EngenhariaTelecom/projeto-integrador-03/documentacao/imagens/telaInicio.png

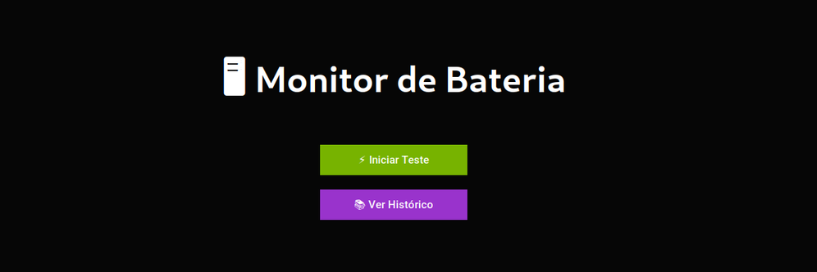
documentacao/imagens/telaInicio.png
