EngenhariaTelecom/projeto-integrador-03/ensaios_de_teste/ensaios/teste_100_ciclo_carga_descarga.csv

Tempo (s) | Tensao (V) | Corrente (A) | Modo | Carga | Descarga | Ciclo
0.1 |  |  | AUTO | OFF | OFF | 0
1.0 | 3.571 | 0.000 | AUTO | ON | OFF | 0
2.1 | 4.097 | 0.000 | AUTO | ON | OFF | 0
3.1 | 4.108 | 0.000 | AUTO | ON | OFF | 0
4.1 | 4.116 | 0.000 | AUTO | ON | OFF | 0
5.1 | 4.124 | 0.000 | AUTO | ON | OFF | 0
6.0 | 4.130 | 0.000 | AUTO | ON | OFF | 0
7.1 | 4.130 | 0.000 | AUTO | ON | OFF | 0
8.1 | 4.137 | 0.000 | AUTO | ON | OFF | 0
9.1 | 4.144 | 0.000 | AUTO | ON | OFF | 0
10.1 | 4.148 | 0.000 | AUTO | ON | OFF | 0
11.1 | 4.152 | 0.000 | AUTO | ON | OFF | 0
12.1 | 4.156 | 0.000 | AUTO | ON | OFF | 0
13.0 | 4.161 | 0.000 | AUTO | ON | OFF | 0
14.1 | 4.166 | 0.000 | AUTO | ON | OFF | 0
15.2 | 4.166 | 0.000 | AUTO | ON | OFF | 0
16.2 | 4.170 | 0.000 | AUTO | ON | OFF | 0
17.2 | 4.174 | 0.000 | AUTO | ON | OFF | 0
18.2 | 4.175 | 0.000 | AUTO | ON | OFF | 0
19.2 | 4.177 | 0.000 | AUTO | ON | OFF | 0
20.2 | 4.179 | 0.000 | AUTO | ON | OFF | 0
21.1 | 4.178 | 0.000 | AUTO | ON | OFF | 0
22.3 | 4.179 | 0.000 | AUTO | ON | OFF | 0
23.3 | 4.179 | 0.000 | AUTO | ON | OFF | 0
24.3 | 4.179 | 0.000 | AUTO | ON | OFF | 0
25.3 | 4.179 | 0.000 | AUTO | ON | OFF | 0
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
