EngenhariaTelecom/projeto-integrador-03/ensaios_de_teste/ensaios/teste_10_ciclo_carga_descarga.csv

Tempo (s) | Tensao (V) | Corrente (A) | Modo | Carga | Descarga | Ciclo
0.0 |  |  | AUTO | OFF | OFF | 0
1.1 |  |  | AUTO | OFF | OFF | 0
2.1 | 3.776 | 0.000 | AUTO | ON | OFF | 0
3.1 | 4.196 | 0.000 | AUTO | ON | OFF | 0
4.1 | 4.197 | 0.000 | AUTO | ON | OFF | 0
5.1 | 4.198 | 0.000 | AUTO | ON | OFF | 0
6.1 | 4.198 | 0.000 | AUTO | ON | OFF | 0
7.1 | 4.198 | 0.000 | AUTO | ON | OFF | 0
8.1 | 4.200 | 0.000 | AUTO | ON | OFF | 0
9.1 | 4.200 | 0.000 | AUTO | ON | OFF | 0
10.1 | 4.200 | 0.000 | AUTO | OFF | ON | 1
11.2 | 3.720 | 0.000 | MANUAL | OFF | OFF | 1
12.2 | 3.807 | 0.000 | MANUAL | OFF | OFF | 1
13.2 | 3.805 | 0.000 | MANUAL | OFF | OFF | 1
14.2 | 3.804 | 0.000 | MANUAL | OFF | OFF | 1
15.2 | 3.803 | 0.000 | MANUAL | OFF | OFF | 1
16.2 | 3.803 | 0.000 | MANUAL | OFF | OFF | 1
17.2 | 3.803 | 0.000 | MANUAL | OFF | OFF | 1
18.2 | 3.802 | 0.000 | MANUAL | OFF | OFF | 1
19.2 | 3.801 | 0.000 | MANUAL | OFF | OFF | 1
20.2 | 3.801 | 0.000 | MANUAL | OFF | OFF | 1
21.2 | 3.800 | 0.000 | MANUAL | OFF | OFF | 1
22.3 | 3.799 | 0.000 | MANUAL | OFF | OFF | 1
23.3 | 3.799 | 0.000 | MANUAL | OFF | OFF | 1
24.3 | 3.799 | 0.000 | MANUAL | OFF | OFF | 1
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
