EngenhariaTelecom/projeto-integrador-03/ensaios_de_teste/ensaios/teste_1_ciclo_carga.csv

Tempo (s) | Tensao (V) | Corrente (A) | Modo | Carga | Descarga
2.0 | 3.523 | 0.000 | AUTO | ON | OFF
2.0 | 4.004 | 0.000 | AUTO | ON | OFF
2.2 | 4.004 | 0.000 | AUTO | ON | OFF
3.0 | 4.017 | 0.000 | AUTO | ON | OFF
3.3 | 4.017 | 0.000 | AUTO | ON | OFF
4.2 | 4.028 | 0.000 | AUTO | ON | OFF
4.4 | 4.028 | 0.000 | AUTO | ON | OFF
5.4 | 4.036 | 0.000 | AUTO | ON | OFF
5.4 | 4.036 | 0.000 | AUTO | ON | OFF
6.5 | 4.036 | 0.000 | AUTO | ON | OFF
6.5 | 4.043 | 0.000 | AUTO | ON | OFF
7.6 | 4.043 | 0.000 | AUTO | ON | OFF
7.7 | 4.050 | 0.000 | AUTO | ON | OFF
8.6 | 4.050 | 0.000 | AUTO | ON | OFF
8.8 | 4.059 | 0.000 | AUTO | ON | OFF
9.7 | 4.059 | 0.000 | AUTO | ON | OFF
10.0 | 4.066 | 0.000 | AUTO | ON | OFF
10.8 | 4.066 | 0.000 | AUTO | ON | OFF
11.2 | 4.071 | 0.000 | AUTO | ON | OFF
11.8 | 4.071 | 0.000 | AUTO | ON | OFF
12.3 | 4.077 | 0.000 | AUTO | ON | OFF
12.9 | 4.077 | 0.000 | AUTO | ON | OFF
13.5 | 4.083 | 0.000 | AUTO | ON | OFF
14.0 | 4.083 | 0.000 | AUTO | ON | OFF
14.6 | 4.088 | 0.000 | AUTO | ON | OFF
15.0 | 4.088 | 0.000 | AUTO | ON | OFF
15.8 | 4.091 | 0.000 | AUTO | ON | OFF
16.1 | 4.091 | 0.000 | AUTO | ON | OFF
17.0 | 4.096 | 0.000 | AUTO | ON | OFF
17.2 | 4.096 | 0.000 | AUTO | ON | OFF
18.1 | 4.101 | 0.000 | AUTO | ON | OFF
18.3 | 4.101 | 0.000 | AUTO | ON | OFF
19.3 | 4.105 | 0.000 | AUTO | ON | OFF
19.3 | 4.105 | 0.000 | AUTO | ON | OFF
20.4 | 4.105 | 0.000 | AUTO | ON | OFF
20.4 | 4.110 | 0.000 | AUTO | ON | OFF
21.5 | 4.110 | 0.000 | AUTO | ON | OFF
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
1263.0 | 4.201 | 0.000 | AUTO | OFF | ON
1264.1 | 4.201 | 0.000 | AUTO | OFF | ON
1265.1 | 4.201 | 0.000 | AUTO | OFF | ON
1266.2 | 4.201 | 0.000 | AUTO | OFF | ON
1267.3 | 4.201 | 0.000 | AUTO | OFF | ON
1268.4 | 4.201 | 0.000 | AUTO | OFF | ON
1269.5 | 4.201 | 0.000 | AUTO | OFF | ON
