EngenhariaTelecom/projeto-integrador-03/ensaios_de_teste/ensaios/teste_2_ciclo_carga_descarga.csv

Tempo (s) | Tensao (V) | Corrente (A) | Modo | Carga | Descarga | Ciclo
0.1 |  |  | AUTO | OFF | OFF | 0
1.1 |  |  | AUTO | OFF | OFF | 0
2.1 | 3.930 | 0.000 | AUTO | ON | OFF | 0
3.1 | 4.166 | 0.000 | AUTO | ON | OFF | 0
4.1 | 4.166 | 0.000 | AUTO | ON | OFF | 0
5.1 | 4.168 | 0.000 | AUTO | ON | OFF | 0
6.1 | 4.168 | 0.000 | AUTO | ON | OFF | 0
7.1 | 4.170 | 0.000 | AUTO | ON | OFF | 0
8.1 | 4.170 | 0.000 | AUTO | ON | OFF | 0
9.1 | 4.171 | 0.000 | AUTO | ON | OFF | 0
10.2 | 4.172 | 0.000 | AUTO | ON | OFF | 0
11.2 | 4.173 | 0.000 | AUTO | ON | OFF | 0
12.2 | 4.173 | 0.000 | AUTO | ON | OFF | 0
13.2 | 4.171 | 0.000 | AUTO | ON | OFF | 0
14.2 | 4.171 | 0.000 | AUTO | ON | OFF | 0
15.2 | 4.170 | 0.000 | AUTO | ON | OFF | 0
16.2 | 4.170 | 0.000 | AUTO | ON | OFF | 0
17.2 | 4.170 | 0.000 | AUTO | ON | OFF | 0
18.2 | 4.167 | 0.000 | AUTO | ON | OFF | 0
19.3 | 4.167 | 0.000 | AUTO | ON | OFF | 0
20.3 | 4.168 | 0.000 | AUTO | ON | OFF | 0
21.3 | 4.166 | 0.000 | AUTO | ON | OFF | 0
22.3 | 4.168 | 0.000 | AUTO | ON | OFF | 0
23.3 | 4.166 | 0.000 | AUTO | ON | OFF | 0
24.3 | 4.166 | 0.000 | AUTO | ON | OFF | 0
25.3 | 4.167 | 0.000 | AUTO | ON | OFF | 0
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
