EngenhariaTelecom/projeto-integrador-03/(threads)

Thread 1 (2025-08-17):

Criação do Pitch

beatriz-paz, 2025-08-17:

beatriz-paz, 2025-08-17:
## Ideia geral:

- criação de protótipo para teste de carga e descarga de baterias;
- ter uma aplicação desktop que receba localmente as informação do teste (como tensão) e plote um gráfico de Tensão vs Tempo.

_Objetivo: este projeto tem como foco o uso por parte do desenvolvimento de produtos que utilizam baterias. Onde a análise do gráfico gerado pode tanto validar o funcionamento da bateria, como compreender se tal tipo de bateria serve para a aplicação pensada._

### Hardware

- usar a esp32;
- sensores de tensão e corrente;
- banco de resistores (para controle da descarga).

### Software

- Apache - Netbeans (possivelmente);
- recebe via broker mqtt os dados e trata eles para plotagem dos resultados.

Closed 2025-08-21.

Thread 4 (2025-08-31):

Criação de questionário para coletar/alinhar informações para nortear o desenvolvimento

beatriz-paz, 2025-08-31:

julia-e2002, 2025-09-02:
### Pesquisa sobre especificações/características da bateria PSA 3,7V - 500mAh

Esse tipo de bateria é útil em aplicações pequenas, leves, de baixo consumo constante e com poucas variações de temperatura. Além disso, é sensível a sobrecarga/descarga profunda, exigindo circuito de proteção (muitas já possuem).

A [Placa de sinalização sempre acesa ](https://backend.intelbras.com/sites/default/files/2022-10/Datasheet%20PSA125.pdf) da Intelbras utiliza bateria de íon-lítio 3,7V, porém é 600 mAh.

Outras aplicações desse tipo de bateria são:

⦁	[Rastreador de animais de estimação ](https://lipolybatteries.com/3-7v-500mah-lp602240-pet-tracker-polymer-lithium-battery)
⦁	[Monitor de Frequência Cardíaca Fetal](https://lipolybatteries.com/3-7v-500mah-polymer-battery-lp552540-for-fetal-heart-rate-monitor)
⦁	Sensores e Sistemas Embarcados
⦁	Dispositivos portáteis de baixo consumo
⦁	Sistemas de segurança e IoT
⦁	Brinquedos eletrônicos recarregáveis

Alguns datasheets com essas especificações:

⦁	[Li-ion Polymer 500mAh Battery Datasheet](https://www.mouser.com/datasheet/2/855/ASR00035_500mAh-3078648.pdf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)

⦁	[3.7V Lithium Polymer Battery Data Sheet](https://www.fpbattery.com/wp-content/uploads/2024/06/fpbattery-293450-3.7V-500mAh-Lithium-Polymer-Battery-Specification.pdf) (com gráfico de carga e descarga)

⦁	[3.7 V 500mAh Lithium Ion Battery 602535](https://www.ufinebattery.com/images/upload/ufx0212-13-3-7v-500mah-lithium-ion-battery-product-datasheet.pdf) (com gráficos)

Thread 8 (2025-09-02):

M1 - Semana 1 - Pesquisa sobre métodos atuais de teste de baterias

beatriz-paz, 2025-09-02:

BudaKin, 2025-09-07:
Antes de falar de como os testes funcionam, é importante estabelecer alguns conceitos. Cada bateria possui uma especificação própria, então tudo o que for mostrado aqui não se aplica genericamente a qualquer bateria. Para verificar esses dados, é necessário a leitura das informações fornecidas pela fabricante ou por alguma testadora certificada.

Entre as baterias que pretendemos verificar estão:

- [**Bateria de lítio 3,7 V - 500mAh**](https://www.mouser.com/datasheet/2/855/ASR00035_500mAh-3078648.pdf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)
- [**Bateria de lítio 3,7 V - 600 mAh**](https://www.fpbattery.com/wp-content/uploads/2024/06/fpbattery-403450-3.7V-600mAh-Lithium-Polymer-Battery-Specification.pdf)
- [**Bateria de lítio 3,7 V - 1 Ah**](https://www.li-polymer-battery.com/wp-content/uploads/2021/08/LP453653-3.7V-1000mAh-Datasheet.pdf)
- [**Bateria Alcalina 9 V**](https://www.farnell.com/datasheets/1842389.pdf)
- **Bateria de lítio 14,8V - 1500 mAh**
- **Bateria de lítio 14,8 V - 1200 mAh**
- **Bateria de lítio 2 x 12 V - 1,2 Ah**
- **Bateria de lítio 2 x 12 V – 2,3 Ah**

# Especificações de baterias

Quando se fala de bateria, os principais atributos sempre são **capacidade (Ah)** e **tensão (V)**, e isso não é diferente quando falamos de testes. Justamente esses atributos serão responsáveis pelos dados de maior relevância para tabelas, já que podem demonstrar a degradação da bateria.

## Tensão

Juntando informações das baterias, em um datasheet por exemplo, encontra-se a **tensão nominal**, que é justamente a tensão indicada na bateria. Porém, isso não significa que a bateria tem exatamente esse valor.

Na verdade, uma bateria saudável e carregada **deve ter mais que a tensão nominal**.

Por exemplo, a primeira bateria citada anteriormente: *Bateria de lítio 3,7 V - 500mAh*.
Apesar de possuir **3,7 V de tensão nominal**, tende a ter sua tensão com:

- **0% carregada:** ~2,45 V
- **100% carregada:** ~4,20 V

Esses valores podem ser confirmados lendo as especificações fornecidas.

Portanto, antes de qualquer coisa, é importante verificar se sua bateria possui a tensão próxima dessa faixa. Caso ela apresente valores anormais, isso é um forte indício de comprometimento. Normalmente, isso acontece quando uma bateria permanece "parada" por muito tempo, já que existe uma corrente pequena e constante atuando sobre ela — a chamada **corrente de flutuação**.

## Capacidade

Por fim, mas não menos importante, temos a **capacidade da bateria**, medida em **Ampère-hora (Ah)**, que determina quanto de corrente elétrica essa bateria consegue "armazenar".

Exemplo:
Se uma bateria possui **500 mAh**, e ela estiver energizando um aparelho com uma corrente de **50 mA**, essa bateria conseguirá mantê-lo funcionando por **10 horas**.

Esse atributo é relativamente simples de compreender e, por conta disso, é muito testado, já que a sua medição é de fácil reprodução. É nesse momento que entra o **teste de carga e descarga da bateria**, que coloca esse atributo em prova.

Inegavelmente, nenhuma bateria durará para sempre. Por trás de todas as reações químicas realizadas para a carga e uso de uma bateria, sempre haverá sobras de compostos inúteis nesse processo. Assim, a cada ciclo, a bateria perde desempenho.

Os **ciclos de vida da bateria** também são verificados dessa forma, observando-se o impacto que cada reação possui em sua degradação.

Thread 10 (2025-09-08):

M2 - Semana 3 - Pesquisa sobre criação de circuito de carga

beatriz-paz, 2025-09-08:

beatriz-paz, 2025-09-16:
# Circuitos de carga

### Carregador de bateria de 12v:

- https://www.youtube.com/watch?v=SH95hUC7Pus

### Carregador de bateria de 3,7v:

- https://www.fvml.com.br/2020/03/circuito-carregador-de-bateria-li-ion.html
- https://mx.pinterest.com/pin/70650287899242183/
- https://www.facebook.com/61562060977999/posts/carregador-de-bateria-de-l%C3%ADtio-37vesse-%C3%A9-um-circuito-carregador-de-bateria-de-%C3%ADo/122150493692402032/
- https://www.youtube.com/watch?v=pzSDKZdhiQM
- https://www.youtube.com/watch?v=sMWMVoF-3EM
- **https://www.youtube.com/watch?v=OpxyC2taLm4**

Closed 2025-09-22.

Thread 14 (2025-09-23):

M2 - Semana 4 - caso de uso e criação das telas

Lucascf11, 2025-09-23:
O caso de uso inclui o que cada parte do software e o cliente final são capazes de fazer. Na lógica da projeção tem-se que O cliente final é cliente do frontend, que é cliente do backend e este é cliente do hardware. Abaixo podemos verificar os casos de uso e os requisitos:

**Caso de Uso do Frontend**

Abaixo segue o caso de uso do FrontEnd, cujos requisitos são:

- Para que o cliente possa fazer qualquer coisa, ele precisa selecionar a bateria
- Para que o cliente possa pausar ou parar ciclos, ele deve ter iniciado um
- Para que o cliente possa visualizar histórico ou exportar informações, ele precisa ter finalizado ao menos um ciclo

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

**Caso de Uso do Backend**

Em seguida segue o caso de uso do Backend, cujo cliente é o Frontend e os requisitos são:

- Só é possível arquivar informações de ciclo único, mostrar gráfico de carga ou descarga, se iniciar um ciclo único
- Assim como só é possível arquivar informaçoes de vários ciclos, se ao menos dois ciclos tiverem sido finalizados
- O Frontend só consegue mostrar informaçoes de teste atual se ao menos um ou mais ciclos ainda estiverem em andamento

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

**Caso de Uso do Hardware**

Por último, segue o caso de uso do Hardware, cujo cliente é o backend da aplicação e há mais alguns requisitos:

- O backend só consegue informar o tempo de carga ou descarga, após coleta das demais informações
- A informação da saúde da bateria somente pode ser obtida após análise do tempo de carga e descarga em comparação com as especificaçoes da bateria

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

Todos os casos de uso acima unificados dão uma ideia geral de como será a aplicação. As informações que o Backend coleta do hardware são importantes para permitirem as operações do Frontend, que fará a interface com o usuário final e permitir que ele opere o sistema e obtenha as informações que foram propostas no levantamento de requisitos.

No figma, um esboço inicial dos resultados de carga e descarga de acordo com a corrente mAh das baterias sempre sendo de 3,7V:
[Figma baterias](https://www.figma.com/make/cQ8kuYb7TMZIOEGwCy3EgQ/Aplicativo-de-Medi%C3%A7%C3%A3o-de-Bateria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)

Closed 2025-10-07.

Thread 16 (2025-10-07):

M3 - Semana 6 - Estudo sobre chave analógica digital para tornar o circuito genérico para qualquer bateria de até 12v

beatriz-paz, 2025-10-07:
# Chave analógica - circuito de seleção de bateria

- Datasheet: https://br.mouser.com/datasheet/3/101/1/MC14066B-D.PDF

- Vídeo:

     - https://www.youtube.com/watch?v=e-30tZggdhc
     - https://www.youtube.com/watch?v=Gm7hGxGIf58

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

beatriz-paz, 2025-10-07:
Vamos precisar utilizar outro tipo de chave, como um rele, pois esta que estávamos analisando por mais que seja um circuito compacto não atende quanto a corrente de operação.

Closed 2025-10-07.
