EngenhariaTelecom/projeto-integrador-03/bateria_app/core/monitor.py

# core/monitor.py
import serial
import serial.tools.list_ports
from .bateria import BateriaController
import threading
import time
import os
import csv

class ESPReader(threading.Thread):
    """
    Thread que lê dados da ESP32 via serial.
    Grava CSV por timer periódico controlado (para evitar gravações duplicadas).
    Possui controle de envio periódico de comandos (USB ON).
    """

    def __init__(self, porta=None, baudrate=115200):
        super().__init__(daemon=True)

        self.porta = porta
        self.baudrate = baudrate
        self.ser = None

        # IMPORTANTE: não começa rodando, mas run() garante ativação
        self.running = False
        self._stop_requested = False

        self.ultima_leitura = None
        self.ultima_tensao = None
        self.corrente = None
        self.modo = "AUTO"
        self.carga = "OFF"
        self.descarga = "OFF"

        self.arquivo_csv = None
        self.tempo_inicial = time.time()
        self.bateria_controller = BateriaController(self)

        # Envio periódico
        self._envio_ativo = False
        self._thread_envio = None
        self._envio_intervalo = 3
        self._envio_comando = "USB ON"

        # Gravação periódica
        self.enviando = False
        self._save_timer = None
        self._save_interval = 1.0

        # Proteções
        self._last_save_time = 0.0
        self._save_min_interval = 0.8
        self._ciclo_cache = 0

        # Watchdog
        self._ultimo_dado_ts = time.time()
        self._timeout_serial = 5.0

        # Controller (UI)
        self.controller = None


    # ===============================
    # CSV
    # ===============================
    def definir_csv(self, caminho_csv, retomar=False, tempo_decorrido=0):
        self.arquivo_csv = os.path.abspath(caminho_csv)
        pasta = os.path.dirname(self.arquivo_csv)
        os.makedirs(pasta, exist_ok=True)

        if not os.path.exists(self.arquivo_csv):
            with open(self.arquivo_csv, "w", newline='') as f:
                writer = csv.writer(f)
                writer.writerow([
                    "Tempo (s)",
                    "Tensao (V)",
                    "Corrente (A)",
                    "Modo",
                    "Carga",
                    "Descarga",
                    "Ciclo"
                ])

        if retomar:
            # continua o tempo
            self.tempo_inicial = time.time() - float(tempo_decorrido or 0)
        else:
            self.tempo_inicial = time.time()

        self._last_save_time = 0.0
        
    def restaurar_estado(self, modo, carga, descarga):
        """Restaura estado lógico após retomada."""
        self.modo = modo
        self.carga = carga
        self.descarga = descarga


    def set_ciclo(self, valor):
        """TelaMonitoramento deve chamar isso ao atualizar o ciclo."""
        try:
            self._ciclo_cache = int(valor)
        except:
            self._ciclo_cache = 0

    def salvar_csv(self, tensao, corrente):
        """Salva uma linha no CSV. Throttling para evitar duplicatas."""
        # Bloqueia gravação se já requisitado parar
        if self._stop_requested:
            return

        # Só grava se arquivo definido e gravação periódica ativada (enviando)
        if not self.arquivo_csv:
            return
        # Se gravação periódica não estiver ativa, não gravar (evita gravação pela UI)
        if not self.enviando:
            return

        agora = time.time()
        if agora - self._last_save_time < self._save_min_interval:
            # evita gravações repetidas muito próximas (ex.: run + timer + UI)
            return

        self._last_save_time = agora

        t = agora - self.tempo_inicial

        ciclo = getattr(self, "_ciclo_cache", 0)
        try:
            with open(self.arquivo_csv, "a", newline='') as f:
                writer = csv.writer(f)
                writer.writerow([
                    f"{t:.1f}",
                    f"{tensao:.3f}" if tensao is not None else "",
                    f"{corrente:.3f}" if corrente is not None else "",
                    self.modo,
                    self.carga,
                    self.descarga,
                    ciclo
                ])
        except Exception as e:
            print(f"[ESPReader] Erro ao escrever CSV: {e}")

    # ===============================
    # Conexão
    # ===============================
    def conectar(self):
        try:
            if self.porta is None:
                portas = list(serial.tools.list_ports.comports())
                if not portas:
                    raise Exception("Nenhuma porta serial encontrada.")

                for p in portas:
                    try:
                        self.ser = serial.Serial(
                            p.device,
                            self.baudrate,
                            timeout=0.2  # <<< CRÍTICO
                        )
                        time.sleep(1)
                        try:
                            self.ser.reset_input_buffer()
                        except:
                            pass

                        linha = self.ser.readline().decode(errors="ignore").strip()
                        if linha:
                            self.porta = p.device
                            print(f"✅ ESP32 detectada na porta {p.device}")
                            break
                        else:
                            self.ser.close()
                            self.ser = None
                    except Exception:
                        continue

                if not self.ser:
                    raise Exception("Nenhuma ESP32 respondendo.")

            else:
                self.ser = serial.Serial(
                    self.porta,
                    self.baudrate,
                    timeout=0.2  # <<< CRÍTICO
                )
                time.sleep(1)
                print(f"✅ Conectado manualmente à ESP32 na porta {self.porta}")

            self.running = True

        except Exception as e:
            print("❌ Erro ao conectar à ESP32:", e)
            self.running = False
            raise

    # ===============================
    # Loop de leitura principal
    # ===============================
    def run(self):
        falha_inesperada = True
        # 🔴 GARANTE que o loop possa rodar
        self.running = True
        self._stop_requested = False

        try:
            if not self.ser:
                self.conectar()
        except Exception:
            if self.controller:
                self.controller.after(
                    0,
                    self.controller._esp_desconectada_inesperadamente
                )
            return

        self._ultimo_dado_ts = time.time()

        while self.running and not self._stop_requested:
            agora = time.time()

            # -------- WATCHDOG --------
            if agora - self._ultimo_dado_ts > self._timeout_serial:
                print("❌ Timeout serial: ESP desconectada.")
                break

            try:
                if not (self.ser and self.ser.is_open):
                    raise Exception("Serial fechada")

                linha = self.ser.readline().decode(errors="ignore").strip()
            except Exception:
                time.sleep(0.1)
                continue

            if not linha:
                time.sleep(0.05)
                continue

            # -------- DADO RECEBIDO --------
            self._ultimo_dado_ts = agora

            if linha.startswith("Vbat:"):
                partes = [p.strip() for p in linha.split("|")]
                if len(partes) >= 5:
                    try:
                        self.ultima_tensao = float(
                            partes[0].split(":")[1].replace("V", "").strip()
                        )
                        self.modo = partes[1].split(":")[1].strip()
                        self.carga = partes[2].split(":")[1].strip()
                        self.descarga = partes[3].split(":")[1].strip()
                        self.corrente = float(
                            partes[4].split(":")[1].replace("A", "").strip()
                        )

                        self.salvar_csv(
                            self.ultima_tensao,
                            self.corrente
                        )
                    except:
                        pass

        # -------- ENCERRAMENTO --------
        falha_inesperada = not self._stop_requested

        try:
            if self.ser and self.ser.is_open:
                self.ser.close()
        except:
            pass

        self.running = False

        if falha_inesperada and self.controller:
            self.controller.after(
                0,
                self.controller._esp_desconectada_inesperadamente
            )

    # ===============================
    # Envio periódico de comando (USB ON) e inicio do loop de gravação
    # ===============================
    def _sending_thread(self):
        """Thread que envia o comando USB ON a cada intervalo (se ativo)."""
        while self._envio_ativo and self.ser and getattr(self.ser, "is_open", False):
            try:
                self.ser.write((self._envio_comando + "\n").encode())
                print(f"📤 Enviado para ESP32: {self._envio_comando}")
            except Exception as e:
                print(f"[SERIAL] Falha ao enviar '{self._envio_comando}': {e}")
            # aguarda intervalo, mas pode sair se _envio_ativo virar False
            for _ in range(int(self._envio_intervalo * 10)):
                if not self._envio_ativo:
                    break
                time.sleep(0.1)

    def _loop_save(self):
        """Loop de gravação periódica acionado via threading.Timer."""
        if not self.enviando or self._stop_requested:
            return
        try:
            # grava usando os últimos valores lidos
            self.salvar_csv(self.ultima_tensao, self.corrente)
        except Exception as e:
            print("[ESPReader] erro ao salvar CSV:", e)
        # agenda próxima execução
        try:
            self._save_timer = threading.Timer(self._save_interval, self._loop_save)
            self._save_timer.daemon = True
            self._save_timer.start()
        except Exception as e:
            print("[ESPReader] falha ao agendar next save:", e)

    def iniciar_envio_periodico(self, comando="USB ON", intervalo=3):
        """Inicia thread que envia comando periódico à ESP e inicia a gravação periódica."""
        # Inicia envio de comando (thread contínua)
        try:
            self._envio_comando = comando
            self._envio_intervalo = intervalo
            if not (self._thread_envio and self._thread_envio.is_alive()):
                self._envio_ativo = True
                self._thread_envio = threading.Thread(target=self._sending_thread, daemon=True)
                self._thread_envio.start()
        except Exception as e:
            print("[ESPReader] falha ao iniciar thread de envio:", e)

        # Inicia gravação periódica (timer)
        try:
            if not self.enviando:
                self.enviando = True
                # garante que não temos timer ativo
                try:
                    if self._save_timer:
                        self._save_timer.cancel()
                except:
                    pass
                # começa loop de gravação
                self._loop_save()
        except Exception as e:
            print("[ESPReader] falha ao iniciar gravação periódica:", e)

    def parar_envio_periodico(self):
        """Interrompe o envio periódico e a gravação periódica."""
        self._envio_ativo = False
        try:
            if self._thread_envio and self._thread_envio.is_alive():
                # thread verá _envio_ativo False e terminará
                pass
        except:
            pass

        # para gravação periódica
        self.enviando = False
        try:
            if self._save_timer:
                self._save_timer.cancel()
        except:
            pass
        self._save_timer = None

    # ===============================
    # Encerramento
    # ===============================
    def parar(self):
        """Parada limpa: impede gravação e encerra conexão serial."""
        self._stop_requested = True
        self.running = False

        # para timers/loops
        try:
            self.parar_envio_periodico()
        except:
            pass

        # fecha serial para desbloquear readline
        try:
            if self.ser:
                try:
                    self.ser.close()
                except:
                    pass
        except:
            pass

        # tenta aguardar thread terminar (join)
        try:
            if self.is_alive():
                self.join(timeout=1)
        except:
            pass
