EngenhariaTelecom/projeto-integrador-03/bateria_app/ui/autocomplete.py

# ui/autocomplete.py
import tkinter as tk
import ttkbootstrap as ttk

class AutocompleteEntry(ttk.Entry):
    def __init__(self, parent, autocomplete_list=None, placeholder="Digite aqui...", bootstyle=None,
                 on_select_callback=None, max_height=10, *args, **kwargs):
        if bootstyle is None:
            bootstyle = "primary"
        super().__init__(parent, bootstyle=bootstyle, *args, **kwargs)

        self.parent = parent
        self.on_select_callback = on_select_callback
        self.max_height = max_height

        # Lista de sugestões
        if autocomplete_list is None:
            autocomplete_list = []
        self.autocomplete_list = sorted(autocomplete_list, key=str.lower)

        # Se textvariable veio no kwargs, usa ele.
        if "textvariable" in kwargs:
            self.var = kwargs["textvariable"]
        else:
            self.var = tk.StringVar()
            self.config(textvariable=self.var)


        # Placeholder
        self.placeholder = placeholder
        self._has_placeholder = False
        self._set_placeholder()

        # Detecta escrita
        # Detecta escrita (com método seguro)
        self._add_trace()


        # Eventos
        self.bind("<FocusIn>", self._clear_placeholder)
        self.bind("<Right>", self.selection)
        self.bind("<Down>", self.move_down)
        self.bind("<Up>", self.move_up)
        self.bind("<Button-1>", self.show_all)
        self.bind("<Return>", self.enter_pressed)

        # Fechar listbox ao clicar fora do entry ou listbox
        self.winfo_toplevel().bind_all("<Button-1>", self._on_click_outside, add="+")

        # Listbox e scrollbar
        self.listbox_up = False
        self.listbox_frame = None
        self.listbox = None
        self.scrollbar = None

        # Recupera cores do tema ttkbootstrap
        style = ttk.Style()
        self.bg_color = style.lookup('TEntry', 'fieldbackground') or "#ffffff"
        self.fg_color = style.lookup('TEntry', 'foreground') or "#000000"
        self.sel_bg_color = style.lookup('TEntry', 'selectbackground') or "#0d6efd"
        self.sel_fg_color = style.lookup('TEntry', 'selectforeground') or "#ffffff"

    # -------------------------
    # Placeholder
    # -------------------------
    def _set_placeholder(self, *args):
        if not self.var.get():
            self._has_placeholder = True

            # Remove trace temporariamente, mas só se existir
            infos = self.var.trace_info()
            if infos:
                try:
                    self.var.trace_vdelete("write", infos[0][1])
                except Exception:
                    pass

            # Agora aplica placeholder
            self.var.set(self.placeholder)
            self.config(foreground="grey")

            # Restaura trace
            self._add_trace()


    def _clear_placeholder(self, *args):
        if self._has_placeholder:
            self.var.set("")
            self.config(foreground=self.fg_color)
            self._has_placeholder = False

    # -------------------------
    # Atualização da lista
    # -------------------------
    def show_all(self, event=None):
        self._clear_placeholder()
        self.changed()

    def update_list(self, new_list):
        self.autocomplete_list = sorted(new_list, key=str.lower)
        if self.listbox_up:
            self.changed()

    def changed(self, *args):
        if self._has_placeholder:
            return
        txt = self.var.get()
        words = self.autocomplete_list if txt == "" else self.matches(txt)

        if words:
            if not self.listbox_up:
                self.open_listbox()
            self.listbox.delete(0, "end")
            for w in words:
                self.listbox.insert("end", w)
            altura = min(len(words), self.max_height)
            self.listbox.config(height=altura)
        else:
            self.close_listbox()

    def matches(self, text):
        text_l = text.lower()
        return [w for w in self.autocomplete_list if text_l in w.lower()]

    # -------------------------
    # Seleção de item
    # -------------------------
    def selection(self, event):
        if self.listbox_up and self.listbox.curselection():
            self._select_current()
        return "break"

    def _select_current(self):
        sel = self.listbox.curselection()
        if sel:
            self._clear_placeholder()
            self.var.set(self.listbox.get(sel[0]))
            self.icursor("end")
            self.focus_set()
            self.close_listbox()
            if self.on_select_callback:
                self.on_select_callback(self.var.get())

    # -------------------------
    # Enter aceita valor digitado
    # -------------------------
    def enter_pressed(self, event):
        self._clear_placeholder()
        value = self.var.get()
        self.close_listbox()
        if self.on_select_callback:
            self.on_select_callback(value)
        return "break"

    # -------------------------
    # Navegação com setas
    # -------------------------
    def move_up(self, event):
        if not self.listbox_up:
            return "break"
        cur = self.listbox.curselection()
        idx = cur[0] if cur else 0
        if idx > 0:
            self.listbox.selection_clear(0, "end")
            self.listbox.selection_set(idx - 1)
            self.listbox.activate(idx - 1)
        return "break"

    def move_down(self, event):
        if not self.listbox_up:
            return "break"
        cur = self.listbox.curselection()
        idx = cur[0] if cur else -1
        if idx < self.listbox.size() - 1:
            self.listbox.selection_clear(0, "end")
            self.listbox.selection_set(idx + 1)
            self.listbox.activate(idx + 1)
        return "break"

    # -------------------------
    # Listbox flutuante
    # -------------------------
    def open_listbox(self):
        if self.listbox_up:
            return

        self.listbox_frame = tk.Toplevel(self)
        self.listbox_frame.wm_overrideredirect(True)
        x = self.winfo_rootx()
        y = self.winfo_rooty() + self.winfo_height()
        self.listbox_frame.wm_geometry(f"{self.winfo_width()}x100+{x}+{y}")

        self.scrollbar = tk.Scrollbar(self.listbox_frame, orient="vertical")
        self.listbox = tk.Listbox(
            self.listbox_frame,
            yscrollcommand=self.scrollbar.set,
            background=self.bg_color,
            foreground=self.fg_color,
            selectbackground=self.sel_bg_color,
            selectforeground=self.sel_fg_color
        )
        self.scrollbar.config(command=self.listbox.yview)
        self.scrollbar.pack(side="right", fill="y")
        self.listbox.pack(side="left", fill="both", expand=True)

        self.listbox.bind("<<ListboxSelect>>", lambda e: self._select_current())
        self.listbox.bind("<Right>", self.selection)
        self.listbox.bind("<Return>", self.enter_pressed)

        self.listbox_up = True

    def close_listbox(self):
        if self.listbox_up:
            try:
                self.listbox_frame.destroy()
            except Exception:
                pass
        self.listbox_up = False
        self.listbox_frame = None
        self.listbox = None
        self.scrollbar = None

    # -------------------------
    # Fecha listbox se clicar fora do entry ou da listbox
    # -------------------------
    def _on_click_outside(self, event):
        widget = event.widget
        if self.listbox_frame:
            if widget not in (self, self.listbox, self.listbox_frame, self.scrollbar):
                self.close_listbox()

    def _add_trace(self):
        try:
            self.var.trace_add("write", lambda *a: self.changed())
        except:
            self.var.trace("w", self.changed)
