EngenhariaTelecom/projeto-integrador-03/(commit log)

2025-10-06 Adicionando algumas customizações, aceitando baterias a partir de arquivos .json, porém é necessário verificar a centralização dos widgets
2025-10-12 adicionando o codigo da ESP32 no root do repositorio
2025-10-12 versao de teste de comunicacao via serial
    [dados_bateria.csv]
2025-10-26 modificando a tela de seleção
2025-10-26 Modificação na interface e transição de telas
2025-10-26 Correção de emojis que não pegavam no Linux
2025-10-26 Inicio da integração do código da Beatriz
    [dados_bateria.csv]
2025-10-26 adicionando uma integração do ESPReader com a config .csv
    [dados_bateria.csv]
2025-10-26 modificando o monitoramento, para comunicação serial com a ESP
2025-10-26 Adicionando geração de gráfico, e leitura de histórico
2025-10-26 resolvendo a falta de mudança de csv e botão de sair de monitoramento
    [tela_monitoramento.py]
2025-10-28 atualização da firmware para uso com freeRTOS e protocolo serial
2025-10-30 Corrigindo o erro ao fechar o aplicativo, de ele permanecer aberto
    [base_app.py, tela_monitoramento.py]
2025-10-30 Corrigido o problema de não visualização de escolha no Windows
    [autocomplete.py]
2025-11-02 Adicionado a interação da tela_monitoramento com a porta serial, printando os comando realizados
2025-11-02 corrigido o problema de limitação de tensão dos gráficos gerados pelo matplotlib
    [tela_historico.py, tela_monitoramento.py]
2025-11-02 Inicio da diferenciação do modo de ciclos e carga/descarga
2025-11-02 Removido a alternância dobrada dos modos ao trocar de tela, no monitoramento
2025-11-02 Removido o botão de alternar modos, visto que não será utilizado novamente
2025-11-02 inicio do sistema de recuperação de análise de dados, falta apenas ele conseguir continuar de onde parou
2025-11-03 Versão atualizada do monitor, onde ele agora retoma também simulações que tiveram sua ação interrompida
2025-11-04 versao de firmware atualizada
2025-11-05 firmware atualizada para conseguir validar comunicaçao com porta serial
2025-11-09 adicionado o envio de USB ON periodicamente a cada 3s, e tentei simplificar algumas redundancias do código
2025-11-09 melhorias na tela monitoramento, para perceber a leitura de corrente, bem como também saber finalizar o monitoramento dependendo do tipo escolhido
2025-11-09 melhorias no monitoramento, onde ele percebe corretamente se a tensão chegou no limites, além de a adição de um arquivo de simulação de serial, e por fim a mudança no autocomplete, pra aceitar valore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
2025-11-20 ajustado leitura de tensao v2
2025-11-20 firmware 2.0 lendo valor de tensao e corrente corretamente
2025-11-20 firmware 3.0 lendo valor de tensao e corrente corretamente
2025-11-24 modificando o simu.py, para o modo auto funcionar normalmente
2025-11-24 adicionando um programa que concatena todos os arquivos do programa em um só para visualização única
2025-11-24 adicionando tempo de execução e tempo de descanso(exclusivo de ciclos)
2025-11-24 alteração do readme para corresponder melhor à versão atual
2025-11-29 Removendo as opções de bateria para representar o atual estado do protótipo
2025-12-02 Resolvendo bug de minimizar e serial
    [autocomplete.py, base_app.py, monitor.py, tela_monitoramento.py]
2025-12-06 Voltando ESPREADER ao normal
2025-12-06 Revert "Resolvendo bug de minimizar e serial"
    This reverts commit d85b3fa782a13241fae53282ccc3c3b73dd3b382.
    [autocomplete.py, base_app.py, tela_monitoramento.py]
2025-12-06 Revert "Voltando ESPREADER ao normal"
    This reverts commit 26236c5f4b347324552a98778ffb138606892023.
    [monitor.py]
2025-12-07 resolução do problema de ciclos fantasmas, assim como ciclos presentes no csv
    [base_app.py, historico.py, monitor.py, tela_configuracao.py, tela_historico.py, tela_monitoramento.py]
2025-12-07 adicionando o .spec para facilitar a instalador py
2025-12-07 nova tentativa de installer
2025-12-09 ajustado fator de calibracao
2025-12-14 Retomada funcionando, entretando reinicia o modo por completo, há a necessiadade de mudança
2025-12-14 retomada funcional, porém ainda falta resolver sobre retomar descanso
    [base_app.py, monitor.py, tela_monitoramento.py]
2025-12-14 Versão final corrigida da retomada em caso de finalização inesperada
    [base_app.py, tela_monitoramento.py]
2025-12-14 Remoção novamente do máximo de pontos do gráfico
2025-12-15 Arrumando o repositório
    [dados_bateria.csv]
2025-12-15 criando pasta de documentos
2025-12-15 adicionando guia de software
2025-12-16 relatorio de teste
    [teste_100_ciclo_carga_descarga.csv, teste_10_ciclo_carga_descarga.csv, teste_1_ciclo_carga.csv, teste_20_ciclo_carga_descarga.csv, teste_2_ciclo_carga_descarga.csv, teste_4_ciclo_carga_descarga.csv, teste_50_ciclo_carga_descarga.csv, teste_6_ciclo_carga_descarga.csv]
